adafruit/Adafruit-Feather-RP2350-PCB/README.md

## Adafruit Feather RP2350 PCB

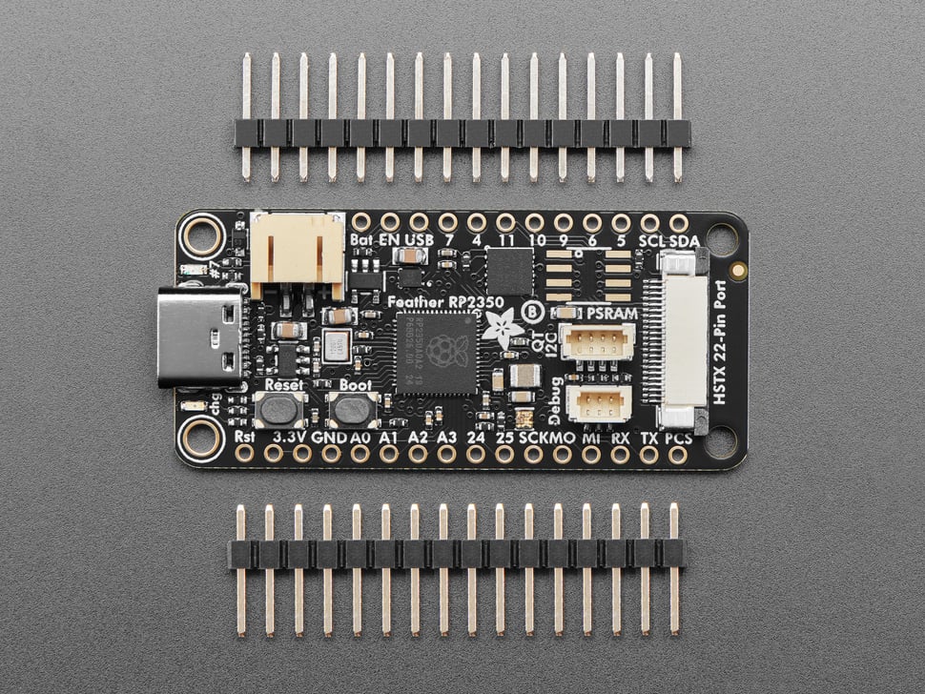
[picture p1: assets/6000.jpg]
<a href="http://www.adafruit.com/products/6000"><br/>
Click here to purchase one from the Adafruit shop</a>

PCB files for the Adafruit Feather RP2350. 

Format is EagleCAD schematic and board layout
* https://www.adafruit.com/product/6000

### Description

RP2350 flies high with the Feather format - now you can use any FeatherWings with this battery-powered dev board. It comes with 8MB of flash, 22pin HSTX output port, Stemma QT, debug SWD, and optional PSRAM spot.

(more soooon!)

Please note: The Adafruit Feather RP2350 HSTX comes with the A2 version of the RP2350, which is affected by the E9 erratum. This errata affects some uses of GPIO and PIO such as high-impedance inputs and the internal pulldowns. You may need to use 8.2K or smaller resistors if pull-downs are required. At this time, Sept 9 2024, there is no other version of the RP2350 available - only the A2 version.

### License

Adafruit invests time and resources providing this open source design, please support Adafruit and open-source hardware by purchasing products from [Adafruit](https://www.adafruit.com)!

Designed by Limor Fried/Ladyada for Adafruit Industries.

Creative Commons Attribution/Share-Alike, all text above must be included in any redistribution. 
See license.txt for additional details.
