adafruit/Adafruit-Feather-RP2350-PCB/Adafruit_Feather_RP2350_prettypins 2.pdf

# Adafruit Feather RP2350

# https://www.adafruit.com/product/6000

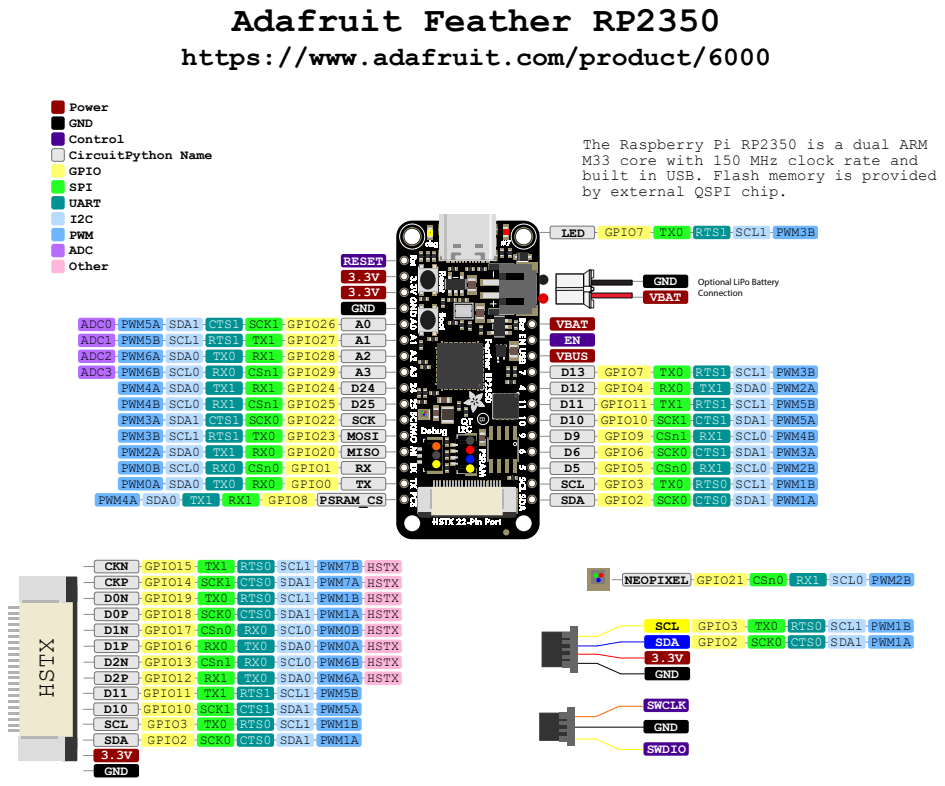
[picture p2: page 1]

The Raspberry Pi RP2350 is a dual ARM
M33 core with 150 MHz clock rate and
built in USB. Flash memory is provided
by external QSPI chip.
LED GPIO7 TX0 RTS1 SCL1 PWM3B
