adafruit/Adafruit-Feather-RP2350-PCB/Adafruit Feather RP2350.brd

## EAGLE design Adafruit Feather RP2350.brd (2024-09-09)

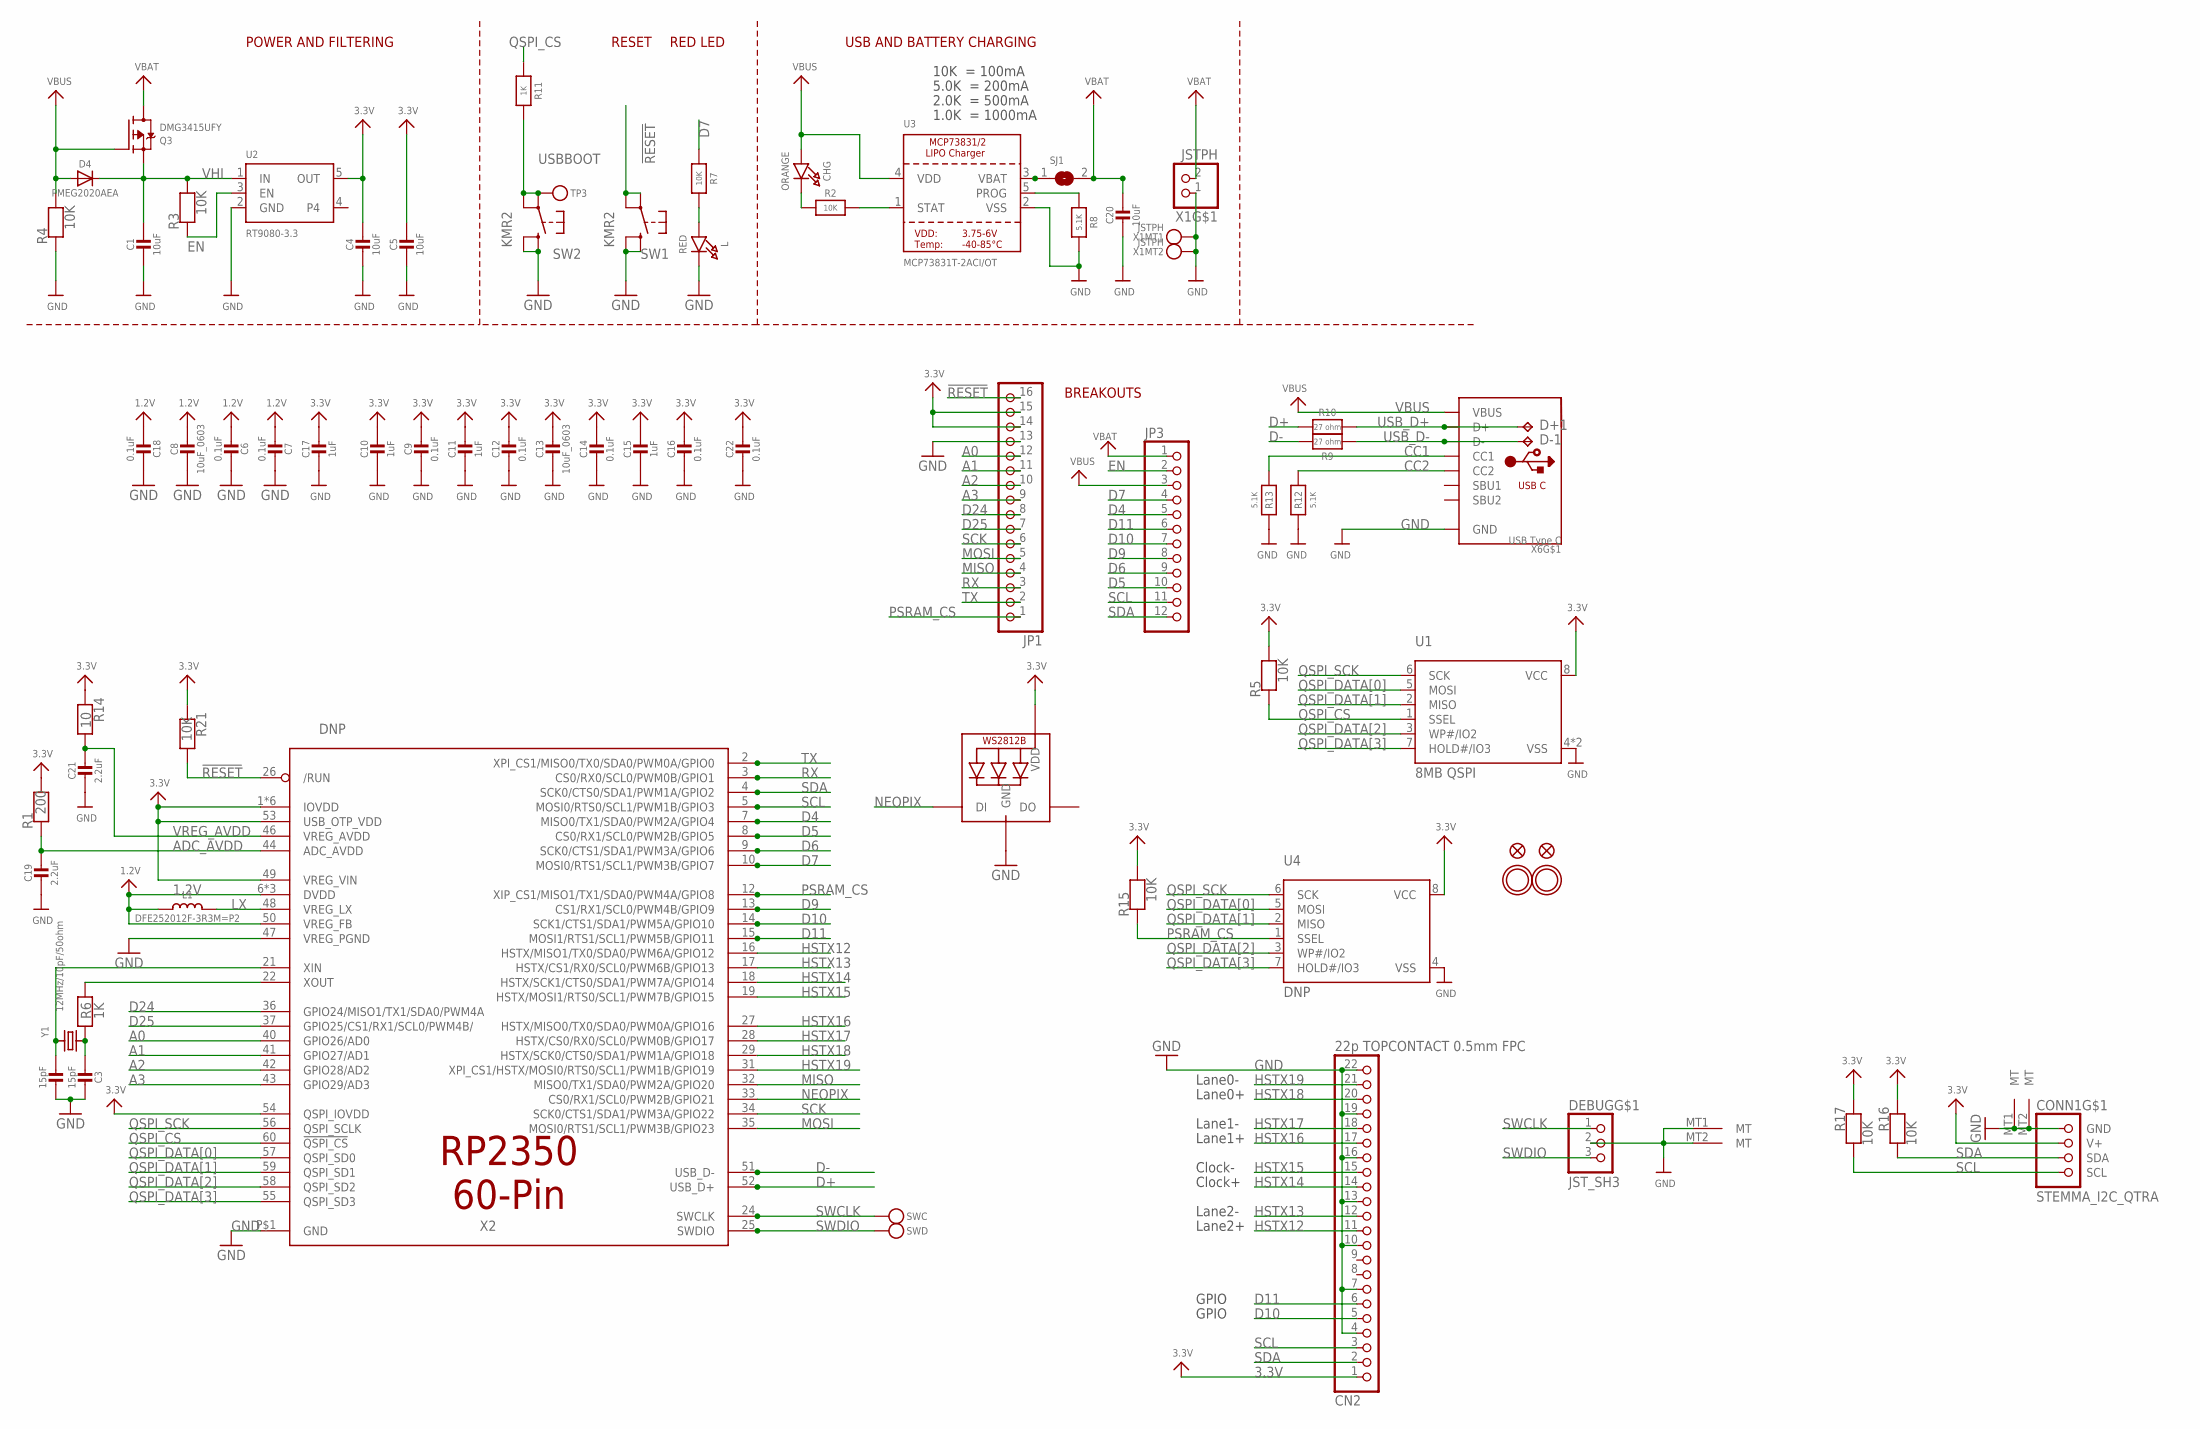
[picture p3: schematic Adafruit Feather RP2350.sch]

Parts:
C1, C4, C20: 10uF; 0805-NO
C2, C3: 15pF; _0402NO
C5: 10uF; 0603-NO
C6, C7, C9, C12, C14, C16, C18, C22: 0.1uF; _0402NO
C8, C13: 10uF_0603; _0603MP
C10, C11, C15, C17: 1uF; _0402NO
C19, C21: 2.2uF; _0402NO
CHG: ORANGE; CHIPLED_0603_NOOUTLINE
CN2: 22p TOPCONTACT 0.5mm FPC; FPC_22PIN
CONN1: STEMMA_I2C_QTRA; JST_SH4_RA
D4: PMEG2020AEA; SOD-323F
D+1: TPB1,27; B1,27
D-1: TPB1,27; B1,27
DEBUG: JST_SH3; JST_SH3_RA
JP1: HEADER-1X16ROUND; 1X16_ROUND
JP3: HEADER-1X12; 1X12_ROUND
L: RED; CHIPLED_0603_NOOUTLINE
L1: DFE252012F-3R3M=P2; INDUCTOR_1007
LED1: WS2812B_SK6805_1515; SK6805_1515
Q3: DMG3415UFY; DFN2015-3
R1: 200; _0402NO
R2, R3, R4, R5, R7, R15, R16, R17, R21: 10K; _0402NO
R6, R11: 1K; _0402NO
R8, R12, R13: 5.1K; _0402NO
R9, R10: 27 ohm; _0402NO
R14: 10; _0402NO
SJ1: SOLDERJUMPERCLOSED; SOLDERJUMPER_CLOSEDWIRE
SW1, SW2: KMR2; BTN_RKB2_4.6X2.8
SWC: TESTPOINTROUND1MM; TESTPOINT_ROUND_1MM
SWD: TESTPOINTROUND1MM; TESTPOINT_ROUND_1MM
TP3: TESTPOINTROUND1.5MMNO; TESTPOINT_ROUND_1.5MM_NO
U1: 8MB QSPI; USON8_4X4
U2: RT9080-3.3; SOT23-5; JLC_ROTATION 0
U3: MCP73831T-2ACI/OT; SOT23-5
U4: DNP; SOIC8_150MIL
U$31, U$32: MOUNTINGHOLE2.5; MOUNTINGHOLE_2.5_PLATED
U$34, U$35: FIDUCIAL_1MM
X1: JSTPH; JSTPH2_BATT
X2: DNP; QFN60_7MM_REDUCEDEPAD
X6: USB Type C; USB_C_CUSB31-CFM2AX-01-X
Y1: 12MHz/10pF/50ohm; CRYSTAL_2.5X2

Connections:
1.2V: C6.2, C7.2, C8.1, C18.2, L1.P$1 (1), X2.6 (DVDD), X2.23 (DVDD), X2.39 (DVDD), X2.50 (VREG_FB)
3.3V: C4.1, C5.1, C9.1, C10.1, C11.1, C12.1, C13.1, C14.1, C15.1, C16.1, C17.1, C22.1, CN2.1, CONN1.2 (V+), JP1.14, JP1.15, LED1.2 (VDD), R1.2, R5.2, R14.1, R15.2, R16.1, R17.1, R21.1, U1.8 (VCC), U2.5 (OUT), U4.8 (VCC), X2.1 (IOVDD), X2.11 (IOVDD), X2.20 (IOVDD), X2.30 (IOVDD), X2.38 (IOVDD), X2.45 (IOVDD), X2.49 (VREG_VIN), X2.53 (USB_OTP_VDD), X2.54 (QSPI_IOVDD)
!RESET: JP1.16, R21.2, SW1.A, SW1.A' (P1), X2.26 (/RUN)
A0: JP1.12, X2.40 (GPIO26/AD0)
A1: JP1.11, X2.41 (GPIO27/AD1)
A2: JP1.10, X2.42 (GPIO28/AD2)
A3: JP1.9, X2.43 (GPIO29/AD3)
ADC_AVDD: C19.1, R1.1, X2.44 (ADC_AVDD)
CC1: R13.2, X6.A5 (CC1)
CC2: R12.2, X6.B5 (CC2)
D4: JP3.5, X2.7 (MISO0/TX1/SDA0/PWM2A/GPIO4)
D5: JP3.10, X2.8 (CS0/RX1/SCL0/PWM2B/GPIO5)
D6: JP3.9, X2.9 (SCK0/CTS1/SDA1/PWM3A/GPIO6)
D7: JP3.4, R7.1, X2.10 (MOSI0/RTS1/SCL1/PWM3B/GPIO7)
D9: JP3.8, X2.13 (CS1/RX1/SCL0/PWM4B/GPIO9)
D10: CN2.5, JP3.7, X2.14 (SCK1/CTS1/SDA1/PWM5A/GPIO10)
D11: CN2.6, JP3.6, X2.15 (MOSI1/RTS1/SCL1/PWM5B/GPIO11)
D24: JP1.8, X2.36 (GPIO24/MISO1/TX1/SDA0/PWM4A)
D25: JP1.7, X2.37 (GPIO25/CS1/RX1/SCL0/PWM4B/)
D+: R10.2, X2.52 (USB_D+)
D-: R9.2, X2.51 (USB_D-)
EN: JP3.2, R3.1, U2.3 (EN)
GND: C1.2, C2.1, C3.1, C4.2, C5.2, C6.1, C7.1, C8.2, C9.2, C10.2, C11.2, C12.2, C13.2, C14.2, C15.2, C16.2, C17.2, C18.1, C19.2, C20.2, C21.2, C22.2, CN2.4, CN2.7, CN2.10, CN2.13, CN2.16, CN2.19, CN2.22, CONN1.1 (GND), CONN1.MT1 (MT), CONN1.MT2 (MT), DEBUG.2, DEBUG.MT1 (MT), DEBUG.MT2 (MT), JP1.13, L.C, LED1.4 (GND), R4.1, R8.2, R12.1, R13.1, SW1.B (S), SW1.B' (S1), SW2.B (S), SW2.B' (S1), U1.4 (VSS), U1.PAD (VSS), U2.2 (GND), U3.2 (VSS), U4.4 (VSS), X1.1, X1.NC1, X1.NC2, X2.47 (VREG_PGND), X2.P$1 (GND), X6.A1B12 (GND), X6.B1A12 (GND)
HSTX12: CN2.11, X2.16 (HSTX/MISO1/TX0/SDA0/PWM6A/GPIO12)
HSTX13: CN2.12, X2.17 (HSTX/CS1/RX0/SCL0/PWM6B/GPIO13)
HSTX14: CN2.14, X2.18 (HSTX/SCK1/CTS0/SDA1/PWM7A/GPIO14)
HSTX15: CN2.15, X2.19 (HSTX/MOSI1/RTS0/SCL1/PWM7B/GPIO15)
HSTX16: CN2.17, X2.27 (HSTX/MISO0/TX0/SDA0/PWM0A/GPIO16)
HSTX17: CN2.18, X2.28 (HSTX/CS0/RX0/SCL0/PWM0B/GPIO17)
HSTX18: CN2.20, X2.29 (HSTX/SCK0/CTS0/SDA1/PWM1A/GPIO18)
HSTX19: CN2.21, X2.31 (XPI_CS1/HSTX/MOSI0/RTS0/SCL1/PWM1B/GPIO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)
LX: L1.P$2 (2), X2.48 (VREG_LX)
MISO: JP1.4, X2.32 (MISO0/TX1/SDA0/PWM2A/GPIO20)
MOSI: JP1.5, X2.35 (MOSI0/RTS1/SCL1/PWM3B/GPIO23)
unnamed: CHG.C, R2.1
unnamed: L.A, R7.2
unnamed: R2.2, U3.1 (STAT)
unnamed: R8.1, U3.5 (PROG)
unnamed: C2.2, X2.21 (XIN), Y1.3 (2)
unnamed: C3.2, R6.1, Y1.1
unnamed: R6.2, X2.22 (XOUT)
unnamed: SJ1.1, U3.3 (VBAT)
NEOPIX: LED1.1 (DI), X2.33 (CS0/RX1/SCL0/PWM2B/GPIO21)
PSRAM_CS: JP1.1, R15.1, U4.1 (SSEL), X2.12 (XIP_CS1/MISO1/TX1/SDA0/PWM4A/GPIO8)
QSPI_CS: R5.1, R11.1, U1.1 (SSEL), X2.60 (!QSPI_CS)
QSPI_DATA[0]: U1.5 (MOSI), U4.5 (MOSI), X2.57 (QSPI_SD0)
QSPI_DATA[1]: U1.2 (MISO), U4.2 (MISO), X2.59 (QSPI_SD1)
QSPI_DATA[2]: U1.3 (WP#/IO2), U4.3 (WP#/IO2), X2.58 (QSPI_SD2)
QSPI_DATA[3]: U1.7 (HOLD#/IO3), U4.7 (HOLD#/IO3), X2.55 (QSPI_SD3)
QSPI_SCK: U1.6 (SCK), U4.6 (SCK), X2.56 (QSPI_SCLK)
RX: JP1.3, X2.3 (CS0/RX0/SCL0/PWM0B/GPIO1)
SCK: JP1.6, X2.34 (SCK0/CTS1/SDA1/PWM3A/GPIO22)
SCL: CN2.3, CONN1.4 (SCL), JP3.11, R17.2, X2.5 (MOSI0/RTS0/SCL1/PWM1B/GPIO3)
SDA: CN2.2, CONN1.3 (SDA), JP3.12, R16.2, X2.4 (SCK0/CTS0/SDA1/PWM1A/GPIO2)
SWCLK: DEBUG.1, SWC.P$1, X2.24 (SWCLK)
SWDIO: DEBUG.3, SWD.P$1, X2.25 (SWDIO)
TX: JP1.2, X2.2 (XPI_CS1/MISO0/TX0/SDA0/PWM0A/GPIO0)
USBBOOT: R11.2, SW2.A, SW2.A' (P1), TP3.P$1
USB_D+: D+1.TP, R10.1, X6.A6 (D+), X6.B6 (D+)
USB_D-: D-1.TP, R9.1, X6.A7 (D-), X6.B7 (D-)
VBAT: C20.1, JP3.1, Q3.3 (D), SJ1.2, X1.2
VBUS: CHG.A, D4.A, JP3.3, Q3.1 (G), R4.2, U3.4 (VDD), X6.A4B9 (VBUS), X6.B4A9 (VBUS)
VHI: C1.1, D4.C, Q3.2 (S), R3.2, U2.1 (IN)
VREG_AVDD: C21.1, R14.2, X2.46 (VREG_AVDD)

Notes on the sheet:
POWER AND FILTERING
RESET
10K = 100mA
5.0K = 200mA
2.0K = 500mA
1.0K = 1000mA
USB AND BATTERY CHARGING
BREAKOUTS
RED LED
Lane0-
Lane0+
Lane1-
Lane1+
Clock-
Clock+
Lane2-
Lane2+
GPIO

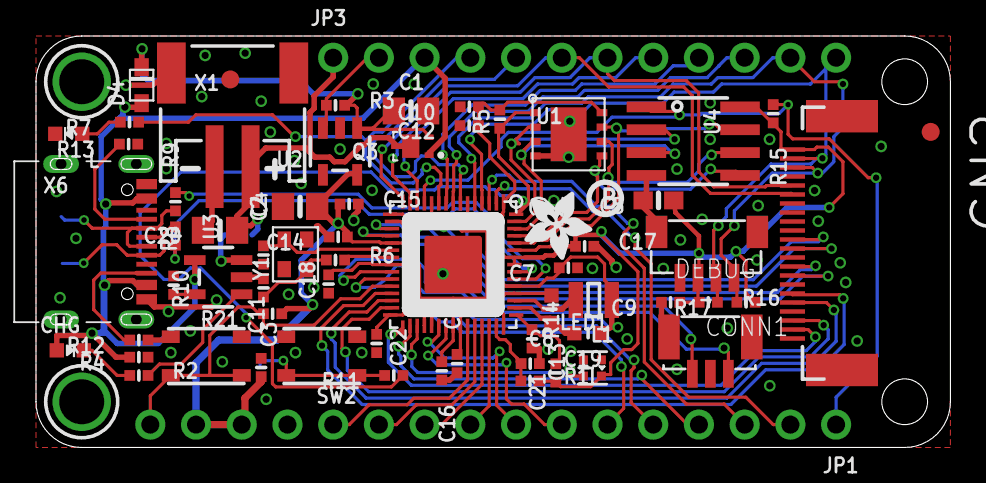
[picture p4: board Adafruit Feather RP2350.brd from above]

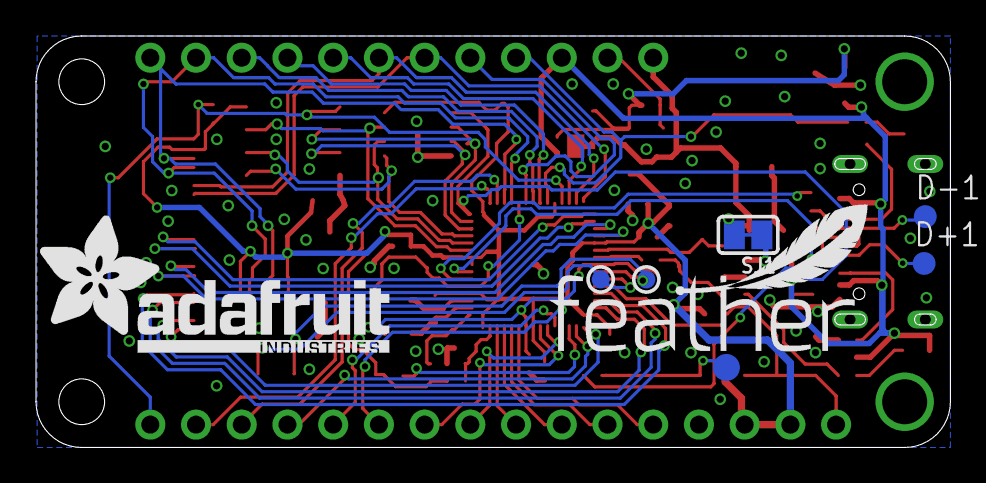
[picture p5: board Adafruit Feather RP2350.brd from below]

Board: 2 copper layers, 50.8 x 22.9 mm, 143 parts (39 on the bottom side), 64 nets.

Other parts of the board:
PLABEL0: PLABEL0
PLABEL1: PLABEL1
PLABEL2: PLABEL2
PLABEL3: PLABEL3
PLABEL4: PLABEL4
PLABEL5: PLABEL5
PLABEL6: PLABEL6
PLABEL7: PLABEL7
PLABEL8: PLABEL8
PLABEL9: PLABEL9
PLABEL10: PLABEL10
PLABEL11: PLABEL11
PLABEL12: PLABEL12
PLABEL13: PLABEL13
PLABEL14: PLABEL14
PLABEL15: PLABEL15
PLABEL16: PLABEL16
PLABEL17: PLABEL17
PLABEL18: PLABEL18
PLABEL19: PLABEL19
PLABEL20: PLABEL20
PLABEL21: PLABEL21
PLABEL22: PLABEL22
PLABEL23: PLABEL23
PLABEL24: PLABEL24
PLABEL25: PLABEL25
PLABEL26: PLABEL26
PLABEL27: PLABEL27
PLABEL28: PLABEL28
PLABEL29: PLABEL29
PLABEL30: PLABEL30
PLABEL31: PLABEL31
PLABEL32: PLABEL32
PLABEL33: PLABEL33
PLABEL34: PLABEL34
PLABEL35: PLABEL35
PLABEL36: PLABEL36
PLABEL37: PLABEL37
PLABEL38: PLABEL38
PLABEL39: PLABEL39
PLABEL40: PLABEL40
PLABEL41: PLABEL41
PLABEL42: PLABEL42
PLABEL43: PLABEL43
PLABEL44: PLABEL44
PLABEL45: PLABEL45
PLABEL46: PLABEL46
PLABEL47: PLABEL47
PLABEL48: PLABEL48
PLABEL49: PLABEL49
PLABEL50: PLABEL50
PLABEL51: PLABEL51
PLABEL52: PLABEL52
PLABEL53: PLABEL53
PLABEL54: PLABEL54
PLABEL55: PLABEL55
PLABEL56: PLABEL56
PLABEL57: PLABEL57
PLABEL58: PLABEL58
PLABEL59: PLABEL59
PLABEL60: PLABEL60
PLABEL61: PLABEL61
PLABEL62: PLABEL62
PLABEL63: PLABEL63
PLABEL64: PLABEL64
PLABEL65: PLABEL65
PLABEL67: PLABEL67
PLABEL68: PLABEL68
U$73: ADAFRUIT_3.5MM
U$74: PCBFEAT-REV-040
U$75: FEATHERLOGO_MED
U$76: ADAFRUIT_TEXT_20MM
