adafruit/Adafruit-Feather-RP2350-PCB/(threads)

Thread 1 (2024-10-06):

Pinout document QT connector GPIO2 and GPIO3 lines are swapped

liudr, 2024-10-06:
The SCL and SDA lines are correctly marked next to the QT connector but the information to the right are swapped. Top line that starts with GPIO3 and bottom line that starts with GPIO2 should be swapped.

Closed 2024-11-18.
